brlabelectronics/Boron-Argon-Relay-Shield/README.md

# Boron-Argon-Relay-Shield
Documents and source code for the Boron-Argon Relay Shield.
The Eagle design files can be found in the PCB design files folder.
