brlabelectronics/Boron-Argon-Relay-Shield/PCB Design Files/BRPBARS4CH.brd

## EAGLE design PCB Design Files/BRPBARS4CH.brd (2022-02-01)

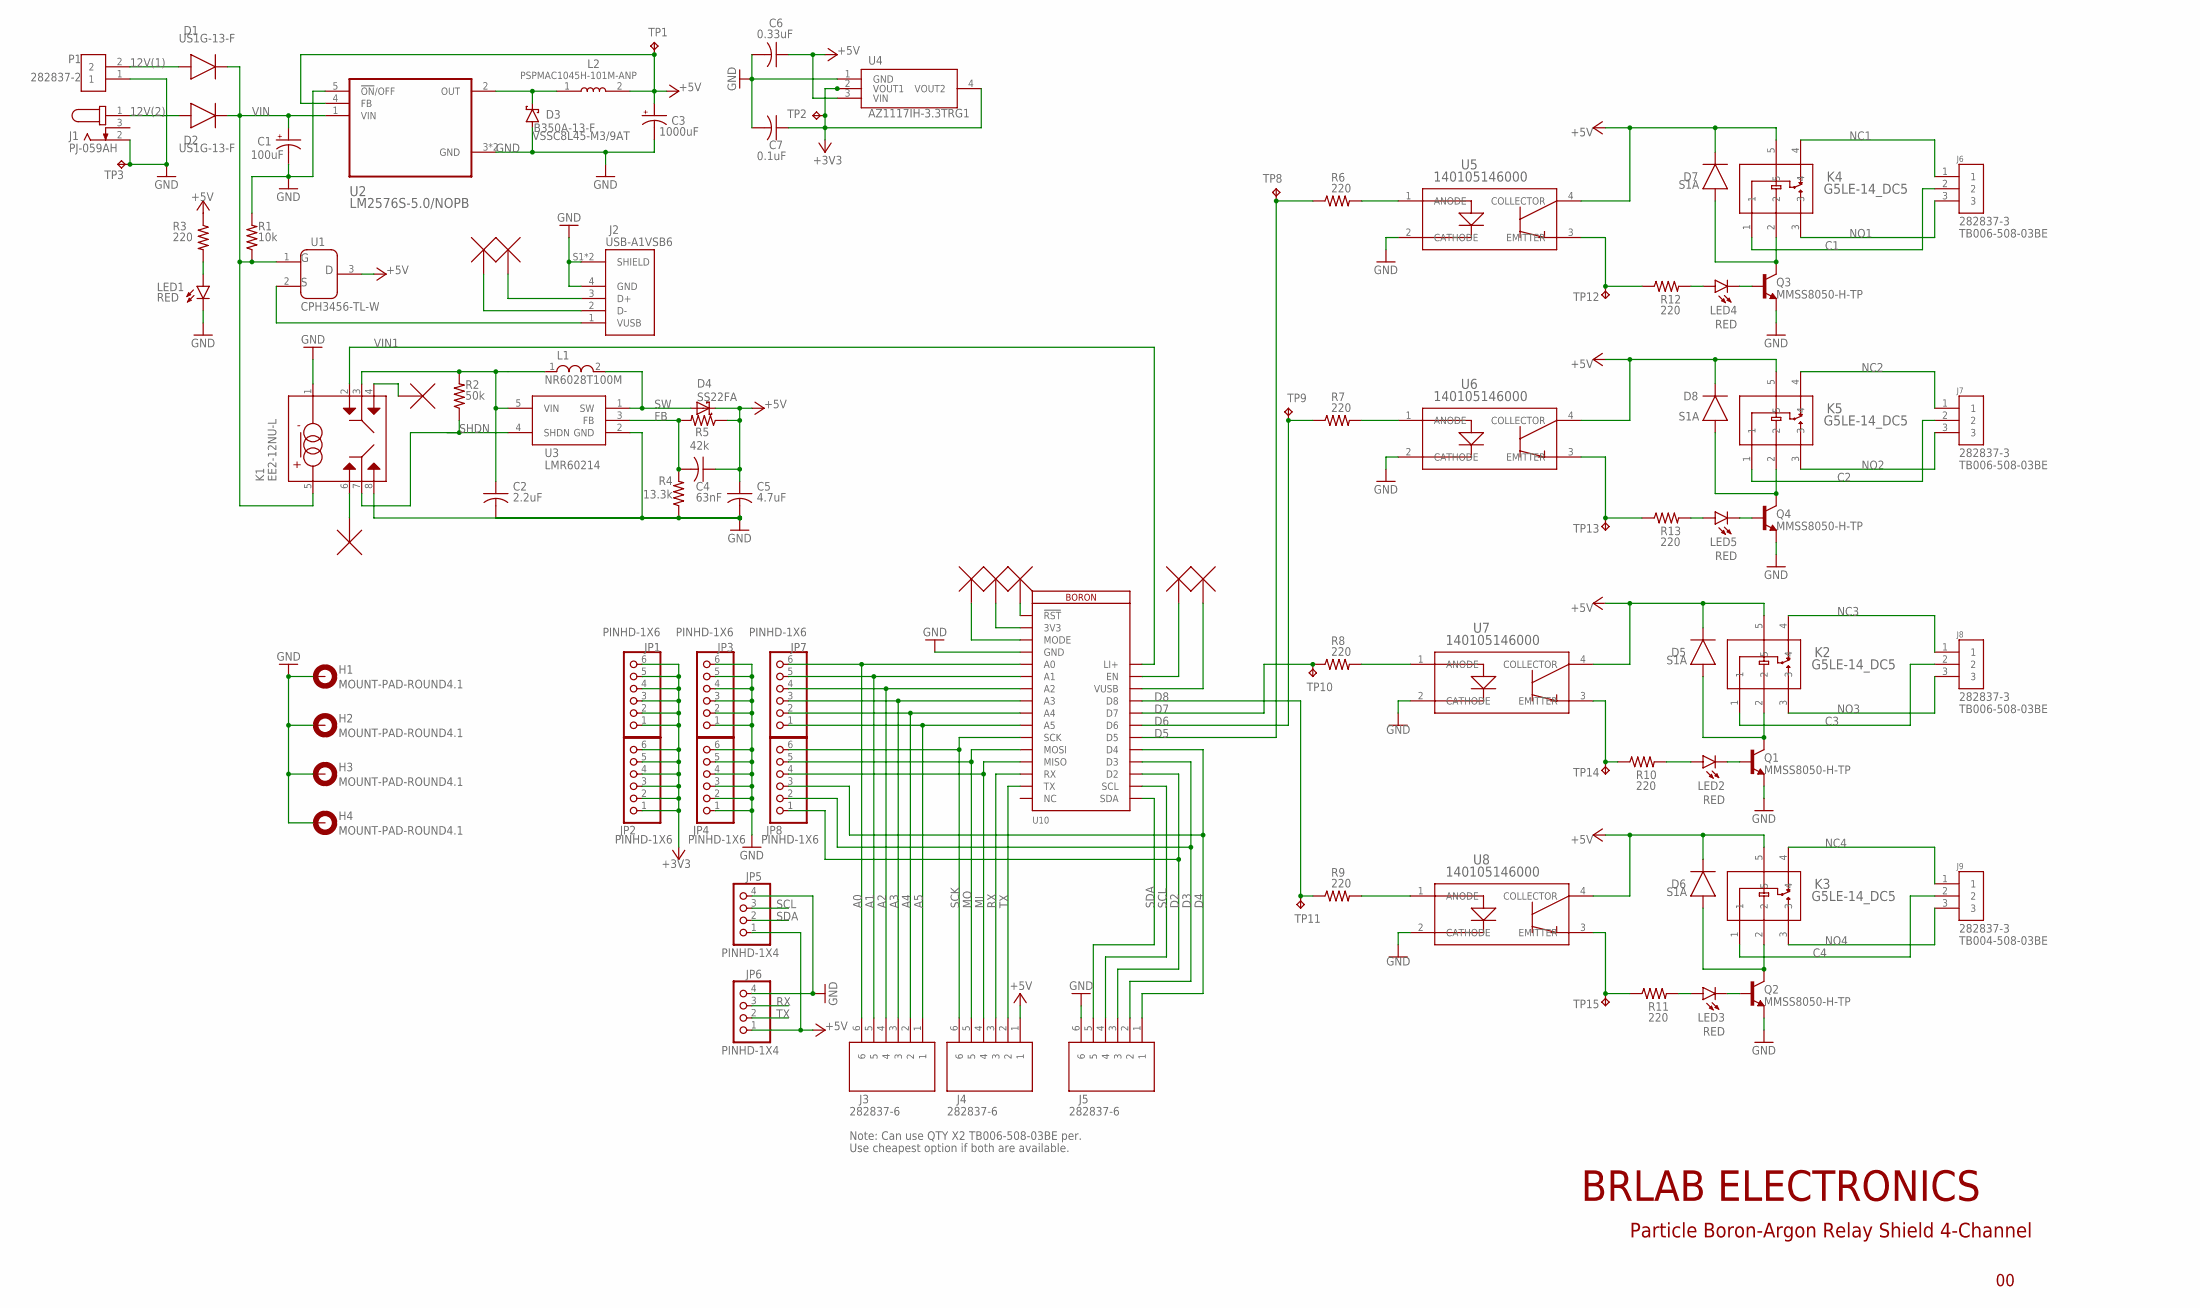
[picture p9: schematic BRPBARS4CH.sch]

Parts:
C1: 100uF; 153CLV-0605
C2: 2.2uF; C0805
C3: 1000uF; 153CLV-0810
C4: 63nF; C0805
C5: 4.7uF; C0805
C6: 0.33uF; C1206
C7: 0.1uF; C1206
D1, D2: RS1G-13-F; DIOM5226X290N
D3: B350A-13-F; SMB
D4: SS22FA
D5, D6, D7, D8: DIODE; DIOM5226X290N
H1, H2, H3, H4: MOUNT-PAD-ROUND4.1; 4,1-PAD
J1: PJ-059AH; CUI_PJ-059AH
J2: USB-A1VSB6; ONSHORE_USB-A1VSB6
J3, J4, J5: 282837-6; TE_282837-6
J6, J7, J8, J9: 282837-3; TE_282837-3
JP1, JP2, JP3, JP4, JP7, JP8: PINHD-1X6; 1X06
JP5, JP6: PINHD-1X4; 1X04
K1: EE2-12NU-L
K2, K3, K4, K5: G5LE-14_DC5; RELAY_G5LE-1_DC5_OMR
L1: NR6028T100M
L2: 100uH; PSPMAC1045H-101M-ANP
LED1, LED2, LED3, LED4, LED5: RED; CHIPLED_1206
P1: 282837-2; TE_282837-2
Q1, Q2, Q3, Q4: MMSS8050-H-TP; TRANS_MMSS8050-H-TP
R1: 10k; R1206
R2: 50k; R0805
R3, R6, R7, R8, R9, R10, R11, R12, R13: 220; R1206
R4: 13.3k; R0805
R5: 42k; R0805
TP1, TP2, TP3, TP8, TP9, TP10, TP11, TP12, TP13, TP14, TP15: TPB1,27; B1,27
U1: CPH3456-TL-W
U2: LM2576S-5.0/NOPB; VREG_TPS79625KTTR
U3: LMR60214; SOT95P280X145-5N
U4: AZ1117IH-3.3TRG1; SOT223
U5, U6, U7, U8: 140105146000; SO_5146000_WRE
U10: BORON

Connections:
12V(1): D1.2 (A), P1.2
12V(2): D2.2 (A), J1.1
+3V3: C7.1, JP1.1, JP1.2, JP1.3, JP1.4, JP1.5, JP1.6, JP2.1, JP2.2, JP2.3, JP2.4, JP2.5, JP2.6, TP2.TP, U4.2 (VOUT1), U4.4 (VOUT2)
+5V: C3.+, C4.1, C5.1, C6.1, D4.2 (C), D5.1 (C), D6.1 (C), D7.1 (C), D8.1 (C), J4.1, JP5.1, JP6.1, K2.5, K3.5, K4.5, K5.5, L2.2, R3.1, R5.1, TP1.TP, U1.3, U2.4 (FB), U4.3 (VIN), U5.4 (COLLECTOR), U6.4 (COLLECTOR), U7.4 (COLLECTOR), U8.4 (COLLECTOR)
A0: J3.6, JP7.6, U10.5 (A0)
A1: J3.5, JP7.5, U10.6 (A1)
A2: J3.4, JP7.4, U10.7 (A2)
A3: J3.3, JP7.3, U10.8 (A3)
A4: J3.2, JP7.2, U10.9 (A4)
A5: J3.1, JP7.1, U10.10 (A5)
C1: J6.2, K4.1
C2: J7.2, K5.1
C3: J8.2, K2.1
C4: J9.2, K3.1
D2: J5.3, JP8.1, U10.19 (D2)
D3: J5.2, JP8.2, U10.20 (D3)
D4: J5.1, JP8.3, U10.21 (D4)
D5: R6.1, TP8.TP, U10.22 (D5)
D6: R7.1, TP9.TP, U10.23 (D6)
D7: R8.1, TP10.TP, U10.24 (D7)
D8: R9.1, TP11.TP, U10.25 (D8)
FB: C4.2, R4.2, R5.2, U3.3 (FB)
GND: C1.-, C2.2, C3.-, C5.2, C6.2, C7.2, D3.A, H1.B4,1, H2.B4,1, H3.B4,1, H4.B4,1, J1.2, J2.4 (GND), J2.S1 (SHIELD), J2.S2 (SHIELD), J5.6, JP3.1, JP3.2, JP3.3, JP3.4, JP3.5, JP3.6, JP4.1, JP4.2, JP4.3, JP4.4, JP4.5, JP4.6, JP5.4, JP6.4, K1.1, K1.8, LED1.C, P1.1, Q1.2 (E), Q2.2 (E), Q3.2 (E), Q4.2 (E), R1.2, R4.1, TP3.TP, U2.3 (GND), U2.5 (!ON!/OFF), U2.6 (GND), U3.2 (GND), U4.1 (GND), U5.2 (CATHODE), U6.2 (CATHODE), U7.2 (CATHODE), U8.2 (CATHODE), U10.4 (GND)
MI: J4.4, JP8.4, U10.13 (MISO)
MO: J4.5, JP8.5, U10.12 (MOSI)
unnamed: R12.1, TP12.TP, U5.3 (EMITTER)
unnamed: LED2.A, R10.2
unnamed: D7.2 (A), K4.2, Q3.3 (C)
unnamed: LED4.C, Q3.1 (B)
unnamed: LED5.C, Q4.1 (B)
unnamed: D8.2 (A), K5.2, Q4.3 (C)
unnamed: LED3.A, R11.2
unnamed: LED4.A, R12.2
unnamed: R9.2, U8.1 (ANODE)
unnamed: R8.2, U7.1 (ANODE)
unnamed: C2.1, K1.3, L1.1, R2.2, U3.5 (VIN)
unnamed: LED5.A, R13.2
unnamed: R11.1, TP15.TP, U8.3 (EMITTER)
unnamed: R10.1, TP14.TP, U7.3 (EMITTER)
unnamed: R6.2, U5.1 (ANODE)
unnamed: R13.1, TP13.TP, U6.3 (EMITTER)
unnamed: LED1.A, R3.2
unnamed: J2.1 (VUSB), U1.2
unnamed: D5.2 (A), K2.2, Q1.3 (C)
unnamed: R7.2, U6.1 (ANODE)
unnamed: LED2.C, Q1.1 (B)
unnamed: LED3.C, Q2.1 (B)
unnamed: D6.2 (A), K3.2, Q2.3 (C)
NC1: J6.1, K4.4
NC2: J7.1, K5.4
NC3: J8.1, K2.4
NC4: J9.1, K3.4
NO1: J6.3, K4.3
NO2: J7.3, K5.3
NO3: J8.3, K2.3
NO4: J9.3, K3.3
OUT: D3.C, L2.1, U2.2 (OUT)
RX: J4.3, JP6.3, U10.14 (RX)
SCK: J4.6, JP8.6, U10.11 (SCK)
SCL: J5.4, JP5.3, U10.18 (SCL)
SDA: J5.5, JP5.2, U10.17 (SDA)
SHDN: K1.7, R2.1, U3.4 (SHDN)
SW: D4.1 (A), L1.2, U3.1 (SW)
TX: J4.2, JP6.2, U10.15 (TX)
VIN: C1.+, D1.1 (C), D2.1 (C), K1.5, R1.1, U1.1, U2.1 (VIN)
VIN1: K1.2, U10.28 (LI+)

Notes on the sheet:
VSSC8L45-M3/9AT
S1A
PSPMAC1045H-101M-ANP
TB006-508-03BE
282837-3
TB004-508-03BE
US1G-13-F
Note: Can use QTY X2 TB006-508-03BE per.
Use cheapest option if both are available.
Particle Boron-Argon Relay Shield 4-Channel
BRLAB ELECTRONICS

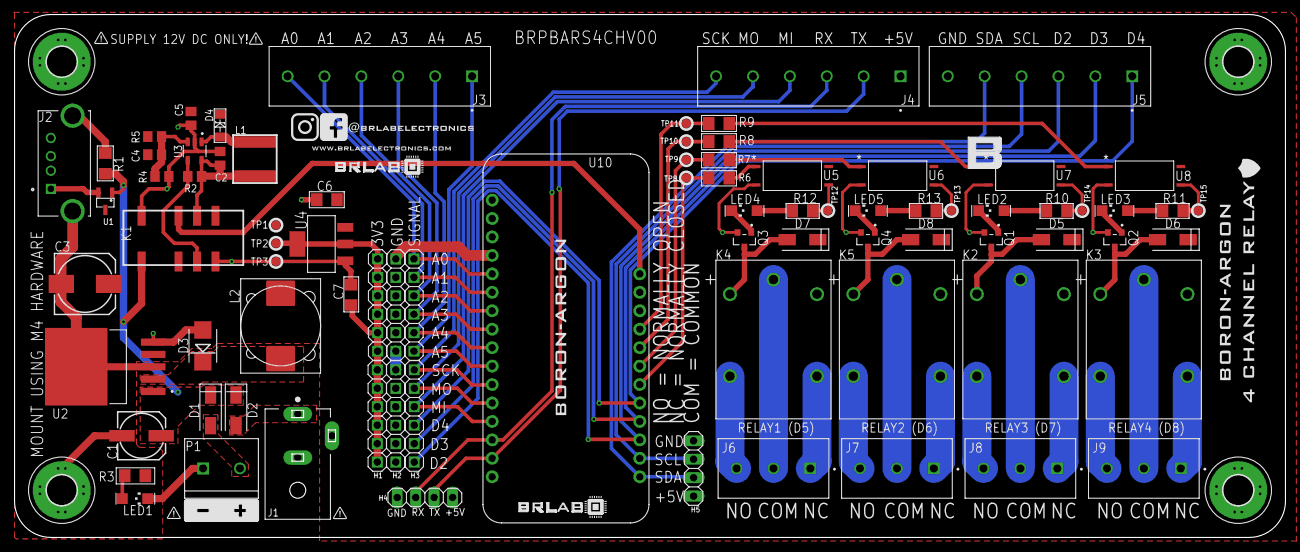
[picture p10: board BRPBARS4CH.brd from above]

Board: 2 copper layers, 175.0 x 72.0 mm, 86 parts (0 on the bottom side), 66 nets.
