brlabelectronics/Boron-Argon-Relay-Shield/Argon_Relay_Scheduler_Option1.ino

/*-------------------------------------------------------------------------------
Argon Relay Time Scheduler
This is the code for the Particle Argon app that communicates and runs 
the Boron-Argon Relay Shield using the Argon.
Company; BRLAB ELECTRONICS
Website: www.brlabelectronics.com
Written By: Bryan Restine
Email: bryan.restine@brlabelectronics.com

Relay 1 Manual ON/OFF BLYNK(V0)
Relay 2 Manual ON/OFF BLYNK(V1)
Relay 3 Manual ON/OFF BLYNK(V2)
Relay 4 Manual ON/OFF BLYNK(V3)
Battery SoC Gauge BLYNK(V4) (optional) (code has been added to run if wanted if not just remove it as the SoC is shown at the top of the Terminal (V5))
Terminal BLYNK(V5)
ALL DAYS Button ON/OFF BLYNK(V6)
WEEKDAYS Button ON/OFF BLYNK(V7)
WEEKEND Button ON/OFF BLYNK(V8)
CUSTOM Button ON/OFF BLYNK(V9)
ALL DAYS Scheduler BLYNK(V10)
WEEKDAYS Scheduler BLYNK(V11)
WEEKEND Scheduler BLYNK(V12)
CUSTOM Scheduler BLYNK(V13)
Relay 1 Selector BLYNK(V14)
Relay 2 Selector BLYNK(V15)
Relay 3 Selector BLYNK(V16)
Relay 4 Selector BLYNK(V17)
---------------------------------------------------------------------------------*/
#define BLYNK_TEMPLATE_ID "***********"  // add your template id here
#define BLYNK_DEVICE_NAME "***************" // add your device name here
#define BLYNK_AUTH_TOKEN "*****************" // add your auth token here

// Comment this out to disable prints and save space
#define BLYNK_PRINT Serial

// This #include statement was automatically added by the Particle IDE.
#include <Blynk.h>

char auth[] = BLYNK_AUTH_TOKEN;

// Attach virtual serial terminal to Virtual Pin V5
WidgetTerminal terminal(V5);

bool isFirstConnect = true;
// constant integer assignment
const int relay1 = 5;
const int relay2 = 6;
const int relay3 = 7;
const int relay4 = 8;

// integer variable assignments
int alldays;
int weekdays;
int weekend;
int custom;
int relay1selected;
int relay2selected;
int relay3selected;
int relay4selected;

// float assignemnts
float voltage = 0;

// Timing variables
unsigned long batterylastmillis = 0;
unsigned long currentTimelastmillis = 0;
unsigned long currentDaylastmillis = 0;
long startsecondswd;
long stopsecondswd;
long nowseconds;

BlynkTimer timer;

BLYNK_CONNECTED() {
if (isFirstConnect) {
  Blynk.syncAll();
  Blynk.notify("TIMER STARTING!!!!");
  isFirstConnect = false;
}
}
BLYNK_WRITE(V0) // relay1 manual on/off
{
    if(param.asInt() == 1)
    {
    // execute this code if the switch widget is now ON
    digitalWrite(relay1, HIGH);  // Set digital pin 5 HIGH
    }
         else
        {
            // execute this code if the switch widget is now OFF
            digitalWrite(relay1, LOW);  // Set digital pin 5 LOW
        }

}
BLYNK_WRITE(V1) // relay2 manual on/off
{
    if(param.asInt() == 1)
    {
    // execute this code if the switch widget is now ON
    digitalWrite(relay2, HIGH);  // Set digital pin 6 HIGH
    }
         else
        {
            // execute this code if the switch widget is now OFF
            digitalWrite(relay2, LOW);  // Set digital pin 6 LOW   
        }

}
BLYNK_WRITE(V2) // relay3 manual on/off
{
    if(param.asInt() == 1)
    {
    // execute this code if the switch widget is now ON
    digitalWrite(relay3, HIGH);  // Set digital pin 7 HIGH
    }
         else
        {
            // execute this code if the switch widget is now OFF
            digitalWrite(relay3, LOW);  // Set digital pin 7 LOW 
        }

}
BLYNK_WRITE(V3) // relay4 manual on/off
{
    if(param.asInt() == 1)
    {
    // execute this code if the switch widget is now ON
    digitalWrite(relay4, HIGH);  // Set digital pin 2 HIGH
    }
         else
        {
          // execute this code if the switch widget is now OFF
          digitalWrite(relay4, LOW);  // Set digital pin 2 LOW     
        }

}
BLYNK_WRITE(V6) // ALL DAYS Schedule Selected
{
  if(param.asInt() == 1)
  {
    alldays = 1;
    weekdays = 0;
    weekend = 0;
    custom = 0;
    Blynk.syncVirtual(V10);
    terminal.clear()
    ;terminal.println("ALL DAYS SCHEDULE HAS BEEN ACTIVATED AT:");
    currentTime();
    terminal.flush();
    currentDay();
  }
  else
  { 
    alldays = 0;
    digitalWrite(relay1, LOW); 
  }
}
BLYNK_WRITE(V7) // WEEKDAYS Schedule Selected
{
  if(param.asInt() == 1)
  {
    alldays = 0;
    weekdays = 1;
    weekend = 0;
    custom = 0;
    Blynk.syncVirtual(V11);
    terminal.clear()
    ;terminal.println("WEEKDAYS SCHEDULE HAS BEEN ACTIVATED AT:");
    currentTime();
    terminal.flush();
    currentDay();
  }
  else
  { 
    weekdays = 0; 
    digitalWrite(relay1, LOW);
  }
}
BLYNK_WRITE(V8) // WEEKEND Schedule Selected
{
  if(param.asInt() == 1)
  {
    alldays = 0;
    weekdays = 0;
    weekend = 1;
    custom = 0;
    Blynk.syncVirtual(V12);
    terminal.clear()
    ;terminal.println("WEEKEND SCHEDULE HAS BEEN ACTIVATED AT:");
    currentTime();
    terminal.flush();
    currentDay();
  }
  else
  { 
    weekend = 0; 
    digitalWrite(relay1, LOW);
  }
}
BLYNK_WRITE(V9) // CUSTOM Schedule Selected
{
  if(param.asInt() == 1)
  {
    alldays = 0;
    weekdays = 0;
    weekend = 0;
    custom = 1;
    Blynk.syncVirtual(V13);
    terminal.clear()
    ;terminal.println("CUSTOM SCHEDULE HAS BEEN ACTIVATED AT:");
    currentTime();
    terminal.flush();
    currentDay();
  }
  else
  { 
    custom = 0;
    digitalWrite(relay1,LOW);
  }
}
BLYNK_WRITE(V10) { // ALL DAYS schedule
  TimeInputParam t(param);
  
  if(alldays == 1)
  {
    int dayadjustment = -1;
    int currentweekday = Time.weekday();
    if(currentweekday == 1)
    {
      dayadjustment = 6; // need for getting Sunday particle Day 1 is Sunday and Blynk is day 7
    }
    if(t.isWeekdaySelected(Time.weekday() + dayadjustment)) //Time library starts week on Sunday, Blynk on Monday. Check to see if current day is selected
    { 
      terminal.println("ALL DAYS SCHEDULE IS ACTIVE TODAY");
      terminal.flush();
      if (t.hasStartTime()) // Process start time if a start time is avaialbe on the selected day
      {
        String startTime = String("START TIME: ") + String(t.getStartHour()) + ":" + String(t.getStartMinute());
        terminal.println(startTime);
        terminal.flush();
      }
      if (t.hasStopTime()) // Process stop time if a stop time is availbe on the selected day
      {
        String stopTime = String("STOP TIME: ") + String(t.getStopHour()) + ":" + String(t.getStopMinute());
        terminal.println(stopTime);
        terminal.flush();
      }
      // Display timezone details, for information purposes only 
      terminal.println(String("Time zone: ") + t.getTZ()); // Timezone is already added to start/stop time 
      //  terminal.println(String("Time zone offset: ") + t.getTZ_Offset()); // Get timezone offset (in seconds)
      terminal.flush();
      for (int i = 1; i <= 7; i++) // Process weekdays (1. Mon, 2. Tue, 3. Wed, ...)
      {  
        if (t.isWeekdaySelected(i)) // determine which days are selected to show to user 
        {
          terminal.print("SELECTED DAY: ");
          switch (i)
          {
             case 1:
            terminal.println("Monday");
            terminal.flush();
            break;
            case 2:
            terminal.println("Tuesday");
            terminal.flush();
            break;
            case 3: 
            terminal.println("Wednesday");
            terminal.flush();
            break;
            case 4:
            terminal.println("Thurday");
            terminal.flush();
            break;
            case 5:
            terminal.println("Friday");
            terminal.flush();
            break;
            case 6:
            terminal.println("Saturday");
            terminal.flush();
            break;
            case 7:
            terminal.println("Sunday");
            terminal.flush();
            break;
          }
        }
      } 
      nowseconds = ((Time.hour() * 3600) + (Time.minute() * 60) + Time.second()); // calcualted the current time in seconds
      startsecondswd = (t.getStartHour() * 3600) + (t.getStartMinute() * 60); // calculate the selected start time in seconds
      //Serial.println(startsecondswd);  // used for debugging
      //terminal.print("Now Seconds: ");
      //terminal.println(nowseconds);
      //terminal.print("Start Seconds: ");
      //terminal.println(startsecondswd);
      if(nowseconds >= startsecondswd) // determine if the relay needs to be switched on [if(nowseconds >= startsecondswd) == true then turn on the relay]
      {    
        if(nowseconds <= startsecondswd + 90) // 90s on 60s timer ensures 1 trigger command is sent
        {    
          // put code here to run relays
          if(relay1selected == 1)
          {
           digitalWrite(relay1, HIGH);
           terminal.println("RELAY1 TURNED ON"); 
          }
          if(relay2selected == 1)
          {
           digitalWrite(relay2, HIGH);
           terminal.println("RELAY2 TURNED ON"); 
          }
           if(relay3selected == 1)
          {
           digitalWrite(relay3, HIGH);
           terminal.println("RELAY3 TURNED ON"); 
          }
          if(relay4selected == 1)
          {
           digitalWrite(relay4, HIGH);
           terminal.println("RELAY4 TURNED ON"); 
          }
          //String currentTime = String("Current Time: ") + String(Time.hourFormat12()) + ":" + String(Time.minute());
          //terminal.println(currentTime); // current time in hours and minutes
          terminal.flush();
        }      
      }
      else
      {
        terminal.println("ALL DAYS DEVICE NOT STARTED TODAY");
        terminal.flush();
      }
      stopsecondswd = (t.getStopHour() * 3600) + (t.getStopMinute() * 60);
      if(nowseconds >= stopsecondswd) // determine if the relay needs to be switched off [if(nowseconds >= stopsecondswd) == true then turn off the relay]
      {
        if(nowseconds <= stopsecondswd + 90) // 90s on 60s timer ensures 1 trigger command is sent
        {   
          // code here to switch the relay OFF
          if(relay1selected == 1)
          {
           digitalWrite(relay1, LOW);
           terminal.println("RELAY1 TURNED OFF");
          }
          if(relay2selected == 1)
          {
           digitalWrite(relay2, LOW);
           terminal.println("RELAY2 TURNED OFF");
          }
          if(relay3selected == 1)
          {
           digitalWrite(relay3, LOW);
           terminal.println("RELAY3 TURNED OFF");
          }
          if(relay4selected == 1)
          {
           digitalWrite(relay4, LOW);
           terminal.println("RELAY4 TURNED OFF");
          }
          terminal.flush();
        }              
      }
      else
      {
        if(nowseconds >= startsecondswd)
        {  
          
          terminal.println("ALL DAY DEVICE IS ON");
          terminal.flush();
 
        }           
      }
    }
    else
    {
      terminal.println("ALL DAYS INACTIVE TODAY");
      terminal.flush();
      // nothing to do today, check again in 30 SECONDS time    
    }
    terminal.println();
  }
}
BLYNK_WRITE(V11) { // WEEKDAYS schedule
  TimeInputParam t(param);
  if(weekdays == 1)
  {
    int dayadjustment = -1;
    int currentweekday = Time.weekday();
    if(currentweekday == 1)
    {
      dayadjustment = 6; // need for getting Sunday particle Day 1 is sunday and blynk is day 7
    }
    if(t.isWeekdaySelected(Time.weekday() + dayadjustment))
    { //Time library starts week on Sunday, Blynk on Monday
      terminal.println("WEEKDAYS SCHEDULE IS ACTIVE TODAY");
      terminal.flush();
    if (t.hasStartTime()) // Process start time
    {
      String startTime = String("START TIME: ") + String(t.getStartHour()) + ":" + String(t.getStartMinute());
      terminal.println(startTime);
      terminal.flush();
    }
    if (t.hasStopTime()) // Process stop time
    {
      String stopTime = String("STOP TIME: ") + String(t.getStopHour()) + ":" + String(t.getStopMinute());
      terminal.println(stopTime);
      terminal.flush();
    }
    // Display timezone details, for information purposes only 
    terminal.println(String("Time zone: ") + t.getTZ()); // Timezone is already added to start/stop time 
    //  terminal.println(String("Time zone offset: ") + t.getTZ_Offset()); // Get timezone offset (in seconds)
    terminal.flush();
    for (int i = 1; i <= 7; i++) 
    {  // Process weekdays (1. Mon, 2. Tue, 3. Wed, ...)
     if (t.isWeekdaySelected(i)) 
      {
        terminal.print("SELECTED DAY: ");
        switch (i)
        {
          case 1:
          terminal.println("Monday");
          terminal.flush();
          break;
          case 2:
          terminal.println("Tuesday");
          terminal.flush();
          break;
          case 3: 
          terminal.println("Wednesday");
          terminal.flush();
          break;
          case 4:
          terminal.println("Thurday");
          terminal.flush();
          break;
          case 5:
          terminal.println("Friday");
          terminal.flush();
          break;
          case 6:
          terminal.println("Saturday");
          terminal.flush();
          break;
          case 7:
          terminal.println("Sunday");
          terminal.flush();
          break;
        }
      }
    } 
      nowseconds = ((Time.hour() * 3600) + (Time.minute() * 60) + Time.second());
      startsecondswd = (t.getStartHour() * 3600) + (t.getStartMinute() * 60);
      //Serial.println(startsecondswd);  // used for debugging
      //terminal.print("Now Seconds: ");
      //terminal.println(nowseconds);
      //terminal.print("Start Seconds: ");
      //terminal.println(startsecondswd);
      if(nowseconds >= startsecondswd)
      {    
        if(nowseconds <= startsecondswd + 90) // 90s on 60s timer ensures 1 trigger command is sent
        {    
          // put code here to run relay
          if(relay1selected == 1)
          {
           digitalWrite(relay1, HIGH);
           terminal.println("RELAY1 TURNED ON"); 
          }
          if(relay2selected == 1)
          {
           digitalWrite(relay2, HIGH);
           terminal.println("RELAY2 TURNED ON"); 
          }
           if(relay3selected == 1)
          {
           digitalWrite(relay3, HIGH);
           terminal.println("RELAY3 TURNED ON"); 
          }
          if(relay4selected == 1)
          {
           digitalWrite(relay4, HIGH);
           terminal.println("RELAY4 TURNED ON"); 
          }
          terminal.flush();
          //String currentTime = String("Current Time: ") + String(Time.hourFormat12()) + ":" + String(Time.minute());
          //terminal.println(currentTime); // current time in hours and minutes
        }      
      }
      else
      {
        terminal.println("WEEKDAYS DEVICE NOT STARTED TODAY"); // print to the user that the device has not started today
        terminal.flush();
      }
      stopsecondswd = (t.getStopHour() * 3600) + (t.getStopMinute() * 60);
      if(nowseconds >= stopsecondswd)
      {
        if(nowseconds <= stopsecondswd + 90) // 90s on 60s timer ensures 1 trigger command is sent
        {   
          if(relay1selected == 1)
          {
           digitalWrite(relay1, LOW);
           terminal.println("RELAY1 TURNED OFF");
          }
          if(relay2selected == 1)
          {
           digitalWrite(relay2, LOW);
           terminal.println("RELAY2 TURNED OFF");
          }
          if(relay3selected == 1)
          {
           digitalWrite(relay3, LOW);
           terminal.println("RELAY3 TURNED OFF");
          }
          if(relay4selected == 1)
          {
           digitalWrite(relay4, LOW);
           terminal.println("RELAY4 TURNED OFF");
          }
          terminal.flush();
        }              
      }
      else
      {
        if(nowseconds >= startsecondswd)
        {  
          terminal.println("WEEKDAYS DEVICE IS ON");
          terminal.flush();
        }           
      }
    }
    else
    {
      terminal.println("WEEKDAYS DEVICE INACTIVE TODAY");
      terminal.flush();
      // nothing to do today, check again in 30 SECONDS time    
    }
    terminal.println();
  }
}
BLYNK_WRITE(V12) { // WEEKEND schedule
  TimeInputParam t(param);
  if(weekend == 1)
  {
    int dayadjustment = -1;
    int currentweekday = Time.weekday();
    if(currentweekday == 1)
    {
      dayadjustment = 6; // need for getting Sunday particle Day 1 is sunday and blynk is day 7
    }
    if(t.isWeekdaySelected(Time.weekday() + dayadjustment))
    { //Time library starts week on Sunday, Blynk on Monday
      terminal.println("WEEKEND SCHEDULE IS ACTIVE TODAY");
      terminal.flush();
    if (t.hasStartTime()) // Process start time
    {
      String startTime = String("START TIME: ") + String(t.getStartHour()) + ":" + String(t.getStartMinute());
      terminal.println(startTime);
      terminal.flush();
    }
    if (t.hasStopTime()) // Process stop time
    {
      String stopTime = String("STOP TIME: ") + String(t.getStopHour()) + ":" + String(t.getStopMinute());
      terminal.println(stopTime);
      terminal.flush();
    }
    // Display timezone details, for information purposes only 
    terminal.println(String("Time zone: ") + t.getTZ()); // Timezone is already added to start/stop time 
    //  terminal.println(String("Time zone offset: ") + t.getTZ_Offset()); // Get timezone offset (in seconds)
    terminal.flush();
    for (int i = 1; i <= 7; i++) 
    {  // Process weekdays (1. Mon, 2. Tue, 3. Wed, ...)
     if (t.isWeekdaySelected(i)) 
      {
        terminal.print("SELECTED DAY: ");
        switch (i)
        {
          case 1:
          terminal.println("Monday");
          terminal.flush();
          break;
          case 2:
          terminal.println("Tuesday");
          terminal.flush();
          break;
          case 3: 
          terminal.println("Wednesday");
          terminal.flush();
          break;
          case 4:
          terminal.println("Thurday");
          terminal.flush();
          break;
          case 5:
          terminal.println("Friday");
          terminal.flush();
          break;
          case 6:
          terminal.println("Saturday");
          terminal.flush();
          break;
          case 7:
          terminal.println("Sunday");
          terminal.flush();
          break;
        }
      }
    } 
      nowseconds = ((Time.hour() * 3600) + (Time.minute() * 60) + Time.second());
      startsecondswd = (t.getStartHour() * 3600) + (t.getStartMinute() * 60);
      //Serial.println(startsecondswd);  // used for debugging
      //terminal.print("Now Seconds: ");
      //terminal.println(nowseconds);
      //terminal.print("Start Seconds: ");
      //terminal.println(startsecondswd);
      if(nowseconds >= startsecondswd)
      {    
        if(nowseconds <= startsecondswd + 90) // 90s on 60s timer ensures 1 trigger command is sent
        {    
          // put code here to run relay
          if(relay1selected == 1)
          {
           digitalWrite(relay1, HIGH);
           terminal.println("RELAY1 TURNED ON"); 
          }
          if(relay2selected == 1)
          {
           digitalWrite(relay2, HIGH);
           terminal.println("RELAY2 TURNED ON"); 
          }
           if(relay3selected == 1)
          {
           digitalWrite(relay3, HIGH);
           terminal.println("RELAY3 TURNED ON"); 
          }
          if(relay4selected == 1)
          {
           digitalWrite(relay4, HIGH);
           terminal.println("RELAY4 TURNED ON"); 
          }
          terminal.flush();
          //String currentTime = String("Current Time: ") + String(Time.hourFormat12()) + ":" + String(Time.minute());
          //terminal.println(currentTime); // current time in hours and minutes
        }      
      }
      else
      {
        terminal.println("WEEKEND DEVICE NOT STARTED TODAY"); // print to the user that the device has not started today
        terminal.flush();
      }
      stopsecondswd = (t.getStopHour() * 3600) + (t.getStopMinute() * 60);
      if(nowseconds >= stopsecondswd)
      {
        if(nowseconds <= stopsecondswd + 90) // 90s on 60s timer ensures 1 trigger command is sent
        {   
          if(relay1selected == 1)
          {
           digitalWrite(relay1, LOW);
           terminal.println("RELAY1 TURNED OFF");
          }
          if(relay2selected == 1)
          {
           digitalWrite(relay2, LOW);
           terminal.println("RELAY2 TURNED OFF");
          }
          if(relay3selected == 1)
          {
           digitalWrite(relay3, LOW);
           terminal.println("RELAY3 TURNED OFF");
          }
          if(relay4selected == 1)
          {
           digitalWrite(relay4, LOW);
           terminal.println("RELAY4 TURNED OFF");
          }
          terminal.flush();
        }              
      }
      else
      {
        if(nowseconds >= startsecondswd)
        {  
          terminal.println("WEEKEND DEVICE IS ON");
          terminal.flush();
        }           
      }
    }
    else
    {
      terminal.println("WEEKEND DEVICE INACTIVE TODAY");
      terminal.flush();
      // nothing to do today, check again in 30 SECONDS time    
    }
    terminal.println();
  }
}
BLYNK_WRITE(V13) { // CUSTOM schedule
  TimeInputParam t(param);
  if(custom == 1)
  {
    int dayadjustment = -1;
    int currentweekday = Time.weekday();
    if(currentweekday == 1)
    {
      dayadjustment = 6; // need for getting Sunday particle Day 1 is sunday and blynk is day 7
    }
    if(t.isWeekdaySelected(Time.weekday() + dayadjustment))
    { //Time library starts week on Sunday, Blynk on Monday
      terminal.println("CUSTOM SCHEDULE IS ACTIVE TODAY");
      terminal.flush();
    if (t.hasStartTime()) // Process start time
    {
      String startTime = String("START TIME: ") + String(t.getStartHour()) + ":" + String(t.getStartMinute());
      terminal.println(startTime);
      terminal.flush();
    }
    if (t.hasStopTime()) // Process stop time
    {
      String stopTime = String("STOP TIME: ") + String(t.getStopHour()) + ":" + String(t.getStopMinute());
      terminal.println(stopTime);
      terminal.flush();
    }
    // Display timezone details, for information purposes only 
    terminal.println(String("Time zone: ") + t.getTZ()); // Timezone is already added to start/stop time 
    //  terminal.println(String("Time zone offset: ") + t.getTZ_Offset()); // Get timezone offset (in seconds)
    terminal.flush();
    for (int i = 1; i <= 7; i++) 
    {  // Process weekdays (1. Mon, 2. Tue, 3. Wed, ...)
     if (t.isWeekdaySelected(i)) 
      {
        terminal.print("SELECTED DAY: ");
        switch (i)
        {
          case 1:
          terminal.println("Monday");
          terminal.flush();
          break;
          case 2:
          terminal.println("Tuesday");
          terminal.flush();
          break;
          case 3: 
          terminal.println("Wednesday");
          terminal.flush();
          break;
          case 4:
          terminal.println("Thurday");
          terminal.flush();
          break;
          case 5:
          terminal.println("Friday");
          terminal.flush();
          break;
          case 6:
          terminal.println("Saturday");
          terminal.flush();
          break;
          case 7:
          terminal.println("Sunday");
          terminal.flush();
          break;
        }
      }
    } 
      nowseconds = ((Time.hour() * 3600) + (Time.minute() * 60) + Time.second());
      startsecondswd = (t.getStartHour() * 3600) + (t.getStartMinute() * 60);
      //Serial.println(startsecondswd);  // used for debugging
      //terminal.print("Now Seconds: ");
      //terminal.println(nowseconds);
      //terminal.print("Start Seconds: ");
      //terminal.println(startsecondswd);
      if(nowseconds >= startsecondswd)
      {    
        if(nowseconds <= startsecondswd + 90) // 90s on 60s timer ensures 1 trigger command is sent
        {    
          // put code here to run relay
          if(relay1selected == 1)
          {
           digitalWrite(relay1, HIGH);
           terminal.println("RELAY1 TURNED ON"); 
          }
          if(relay2selected == 1)
          {
           digitalWrite(relay2, HIGH);
           terminal.println("RELAY2 TURNED ON"); 
          }
           if(relay3selected == 1)
          {
           digitalWrite(relay3, HIGH);
           terminal.println("RELAY3 TURNED ON"); 
          }
          if(relay4selected == 1)
          {
           digitalWrite(relay4, HIGH);
           terminal.println("RELAY4 TURNED ON"); 
          }
          terminal.flush();
          //String currentTime = String("Current Time: ") + String(Time.hourFormat12()) + ":" + String(Time.minute());
          //terminal.println(currentTime); // current time in hours and minutes
        }      
      }
      else
      {
        terminal.println("CUSTOM DEVICE NOT STARTED TODAY"); // print to the user that the device has not started today
        terminal.flush();
      }
      stopsecondswd = (t.getStopHour() * 3600) + (t.getStopMinute() * 60);
      if(nowseconds >= stopsecondswd)
      {
        if(nowseconds <= stopsecondswd + 90) // 90s on 60s timer ensures 1 trigger command is sent
        {   
          if(relay1selected == 1)
          {
           digitalWrite(relay1, LOW);
           terminal.println("RELAY1 TURNED OFF");
          }
          if(relay2selected == 1)
          {
           digitalWrite(relay2, LOW);
           terminal.println("RELAY2 TURNED OFF");
          }
          if(relay3selected == 1)
          {
           digitalWrite(relay3, LOW);
           terminal.println("RELAY3 TURNED OFF");
          }
          if(relay4selected == 1)
          {
           digitalWrite(relay4, LOW);
           terminal.println("RELAY4 TURNED OFF");
          }
          terminal.flush();
        }              
      }
      else
      {
        if(nowseconds >= startsecondswd)
        {  
          terminal.println("CUSTOM DEVICE IS ON");
          terminal.flush();
        }           
      }
    }
    else
    {
      terminal.println("CUSTOM DEVICE INACTIVE TODAY");
      terminal.flush();
      // nothing to do today, check again in 30 SECONDS time    
    }
    terminal.println();
  }
}
BLYNK_WRITE(V14) // relay1 selected? 
{
  if(param.asInt() == 1)
  {
  // execute this code if the switch widget is now ON
  relay1selected = 1;
  }
  else
  {
    // execute this code if the switch widget is now OFF
    relay1selected = 0;
  }
}
BLYNK_WRITE(V15) // relay2 selected? 
{
  if(param.asInt() == 1)
  {
  // execute this code if the switch widget is now ON
  relay2selected = 1;
  }
  else
  {
    // execute this code if the switch widget is now OFF
    relay2selected = 0;
  }
}
BLYNK_WRITE(V16) // relay2 selected? 
{
  if(param.asInt() == 1)
  {
  // execute this code if the switch widget is now ON
  relay3selected = 1;
  }
  else
  {
    // execute this code if the switch widget is now OFF
    relay3selected = 0;
  }
}
BLYNK_WRITE(V17) // relay2 selected? 
{
  if(param.asInt() == 1)
  {
  // execute this code if the switch widget is now ON
  relay4selected = 1;
  }
  else
  {
    // execute this code if the switch widget is now OFF
    relay4selected = 0;
  }
}
void batteryV(){ // get battery SoC 
  // custom battery function
    double voltage = analogRead(BATT)*0.0011224;
    //String BV = String(voltage,2) + String("V");
    //Particle.publish("Battery Voltage", BV, PRIVATE);
    int SoC = map(voltage, 3.20, 4.12, 0.00, 100.00);
    //String displaySoC = String("      Battery: ") + String(SoC) + String("%");
    //Blynk.setProperty(V5, "label", displaySoC);
    Blynk.virtualWrite(V4, SoC);
}
void currentTime(){ // get current time
  
  int timezoneoffset = -6;
  Time.zone(timezoneoffset);
  int minute = Time.minute();
  if(minute <=9)
  {
   String currentTimefixed = String("Current Time: ") + String(Time.hourFormat12()) + ":" + "0" + String(Time.minute());
   terminal.print(currentTimefixed); // current time in hours and minutes
   terminal.flush();  
  }
  else
  {
   String currentTimefixed = String("Current Time: ") + String(Time.hourFormat12()) + ":" + String(Time.minute());
   terminal.print(currentTimefixed); // current time in hours and minutes
   terminal.flush();
  }
  int isAM = Time.isAM();
  if(isAM == 1){
    terminal.println("AM");
    terminal.flush();
  }
  else{
    terminal.println("PM");
    terminal.flush();
  }
  if(alldays == 1)
  {
  }
}
void currentDay(){ // get current day 
  // function to get current local day for debugging
  int currentweekday = Time.weekday();
  terminal.print("Current Day: ");
  switch (currentweekday)
  {
    case 1:
    terminal.println("Sunday");
    terminal.flush();
    break;
    case 2:
    terminal.println("Monday");
    terminal.flush();
    break;
    case 3: 
    terminal.println("Tuesday");
    terminal.flush();
    break;
    case 4:
    terminal.println("Wednesday");
    terminal.flush();
    break;
    case 5:
    terminal.println("Thursday");
    terminal.flush();
    break;
    case 6:
    terminal.println("Friday");
    terminal.flush();
    break;
    case 7:
    terminal.println("Saturday");
    terminal.flush();
    break;
  }
}
void activetoday(){ // check if schedule should run today and refresh time input widgets
  if(Time.year() != 1970)
  {
   if (alldays == 1) 
   { 
     Blynk.syncVirtual(V10); // sync ALLDAYS time input widget  
   }
   if(weekdays == 1)
   {
     Blynk.syncVirtual(V11); // sync WEEKDAYS time input widget
   }
    if(weekend == 1)
   {
     Blynk.syncVirtual(V12); // sync WEEKEND time input widget
   }
    if(custom == 1)
   {
     Blynk.syncVirtual(V13); // sync CUSTOM time input widget
   }
  }
}
void wifistrength(){
 WiFiSignal sig = WiFi.RSSI();
 float strength = sig.getStrength();
 //String WiFiStrength = String(strength,0) + String("%");
 //Particle.publish("WiFi Strength", WiFiStrength, PRIVATE);
 //String displaywifi = String(" WiFi Strength: ") + String(strength,0) + String("%");
 //Blynk.setProperty(V5, "label", displaywifi);
}
void terminalproperty(){
 WiFiSignal sig = WiFi.RSSI();
 float strength = sig.getStrength();
 double voltage;
 double avgvoltage;
 for(int i = 0; i <= 49; i++)
 {
  voltage = voltage + analogRead(BATT)*0.0011224; 
 }
 avgvoltage = voltage*0.02;
 int SoC = map(avgvoltage, 3.20, 4.20, 0.00, 100.00); 
 String terminalLabel = String("WiFi Strength: ") + String(strength,0) + String("%     Battery SoC: ") + String(SoC) + String("%");
 Blynk.setProperty(V5, "label", terminalLabel);
}
void setup() { // setup code runs once first
 // Debug console
  Serial.begin(115200);
  pinMode(relay1, OUTPUT);
  pinMode(relay2, OUTPUT);
  pinMode(relay3, OUTPUT);  
  pinMode(relay4, OUTPUT);
  delay(5000); // Allow board to settle
  Blynk.begin(auth);
  // Clear the terminal content
  terminal.clear();
  // This will print Blynk Software version to the Terminal Widget when
  // your hardware gets connected to Blynk Server
  terminal.println(F("Relay Shield Argon"));
  terminal.println(F("Blynk v" BLYNK_VERSION ": Device has Booted"));
  currentTime();
  currentDay();
  batteryV();
  terminalproperty();
  terminal.flush();
  timer.setInterval(10000L, activetoday);  // check every 10 SECONDS if schedule should run today 
  timer.setInterval(10000L, wifistrength); // get the wifi strength every 10 seconds
  timer.setInterval(10000L, batteryV);
  timer.setInterval(60000L, currentTime);
  timer.setInterval(3600000L, currentDay);
  timer.setInterval(10000L, terminalproperty); 
}
void loop() {
  Blynk.run();
  timer.run();
  // You can inject your own code or combine it with other sketches.
  // Check other examples on how to communicate with Blynk. Remember
  // to avoid delay() function!
}
