brlabelectronics/Boron-Argon-Relay-Shield/(commit log)

2021-11-19 Added source code for controlling relays over wifi on Particle Argon
2021-11-19 -Added current time and day function and print them to the terminal for debugging purposes
2021-11-19 -All DAYS Scheduler button functionality added (under development)
2021-11-19 -added function to update the ALL DAYS Scheduler on a time interval and ALL DAYS Button state
2021-11-22 Added case structure to alldays
2021-11-22 added weekend & custom buttons
2021-11-22 fixed logic for weekend & custom sch time input widget
    [relayshieldargon.ino]
2021-11-22 added logic so that relay turns off when active time is deselected
2021-11-22 added your own BLYNK TEMPLATE _ID, DEVICE_NAME, and AUTH_TOKEN
2021-12-09 Added buttons and logic to select which relay would be in automatic mode (schedule mode)
2021-12-09 Fixed BLYNK virtual pin labelling. Added wifi signal strength reading
    [relayshieldargon.ino]
2021-12-10 cleaned up code; added wifi strength and battery SoC to Terminal label for user to see
2021-12-10 Added Note About Battery SoC gauge
2021-12-10 added for loop to get average battery voltage for SoC calculation
2022-02-01 -Added PCB design files
    [BRPBARS4CH.brd, BRPBARS4CH.sch]
2022-02-01 Added PCB design files
    [BRPBARS4CH.brd, BRPBARS4CH.sch]
2022-02-07 Added Boron-Argon Relay Shield User Manual
2022-02-09 -Updated Wifi Strength and Battery SoC placement
