brlabelectronics/Boron-Argon-Relay-Shield/(notices)

Notices in the files:
parts and their libraries:
Particle-Devices: Licensing: Designed by Particle.
Optocouplers: COPYRIGHT: Copyright (C) 2021 Ultra Librarian. All rights reserved.
RELAYS: COPYRIGHT: Copyright (C) 2018 Accelerated Designs. All rights reserved
